garnerm91/J1850/ExampleGauge/readme.md

## BOM
- TXS0108 level shifter https://amzn.to/41ehUo2
- RP2040 https://amzn.to/454HPzP
- ST7789 1.69in display https://amzn.to/46y5laV
- J1850 VPW module https://www.ebay.com/usr/mattus.i8wvojtcv
## Example Gauge Drawing
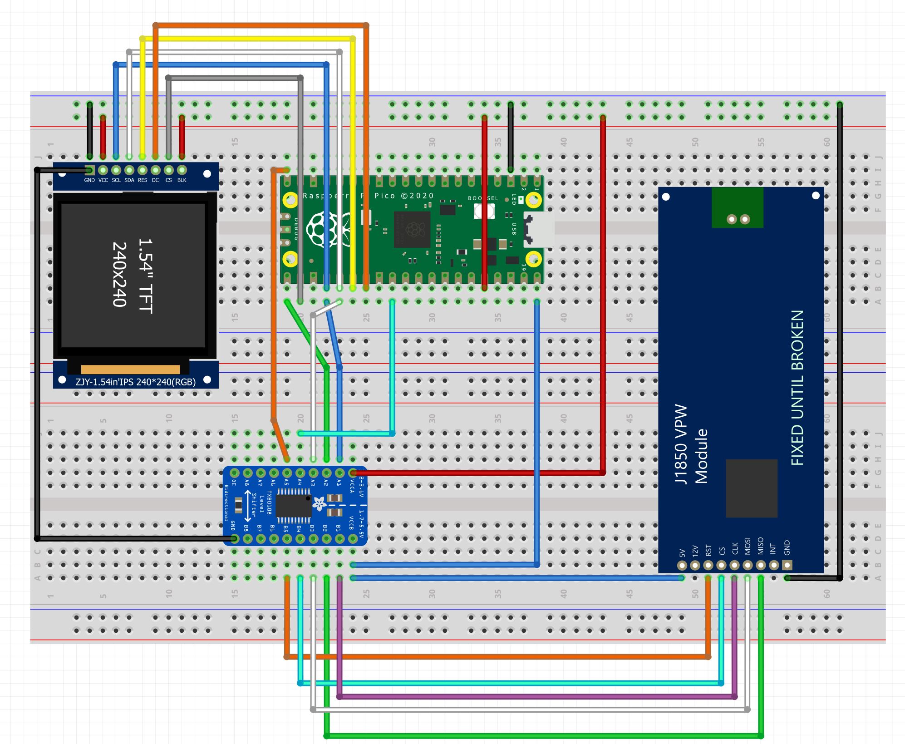
[picture p3: ExampleGauge/gauge.JPG]
PCB

* NOTE: I used a different screen in the drawing, but the one in the BOM is correct.
