garnerm91/J1850/xc68hc58_pro_fw/readme.txt

firmware to go with the xc68hc58 program
It is meant to be used on an Arduino ProMicro (Atmega32U4). The native USB has a more reliable serial for the Datalogging software that this project was meant for.
Tested on UNO as well and works but may have serial issues if pushed pass 115200 baud
