garnerm91/J1850/REVC/REVC SCH.pdf

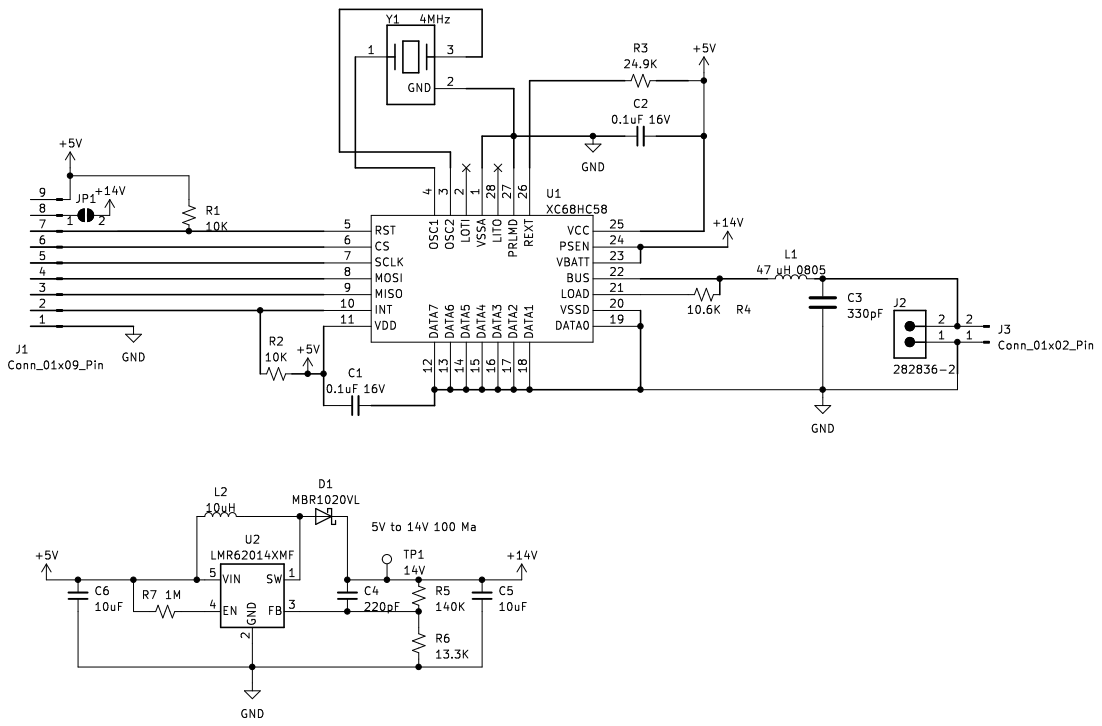
[picture p4: page 1]
