garnerm91/J1850/REV-B/PDF Sch.pdf

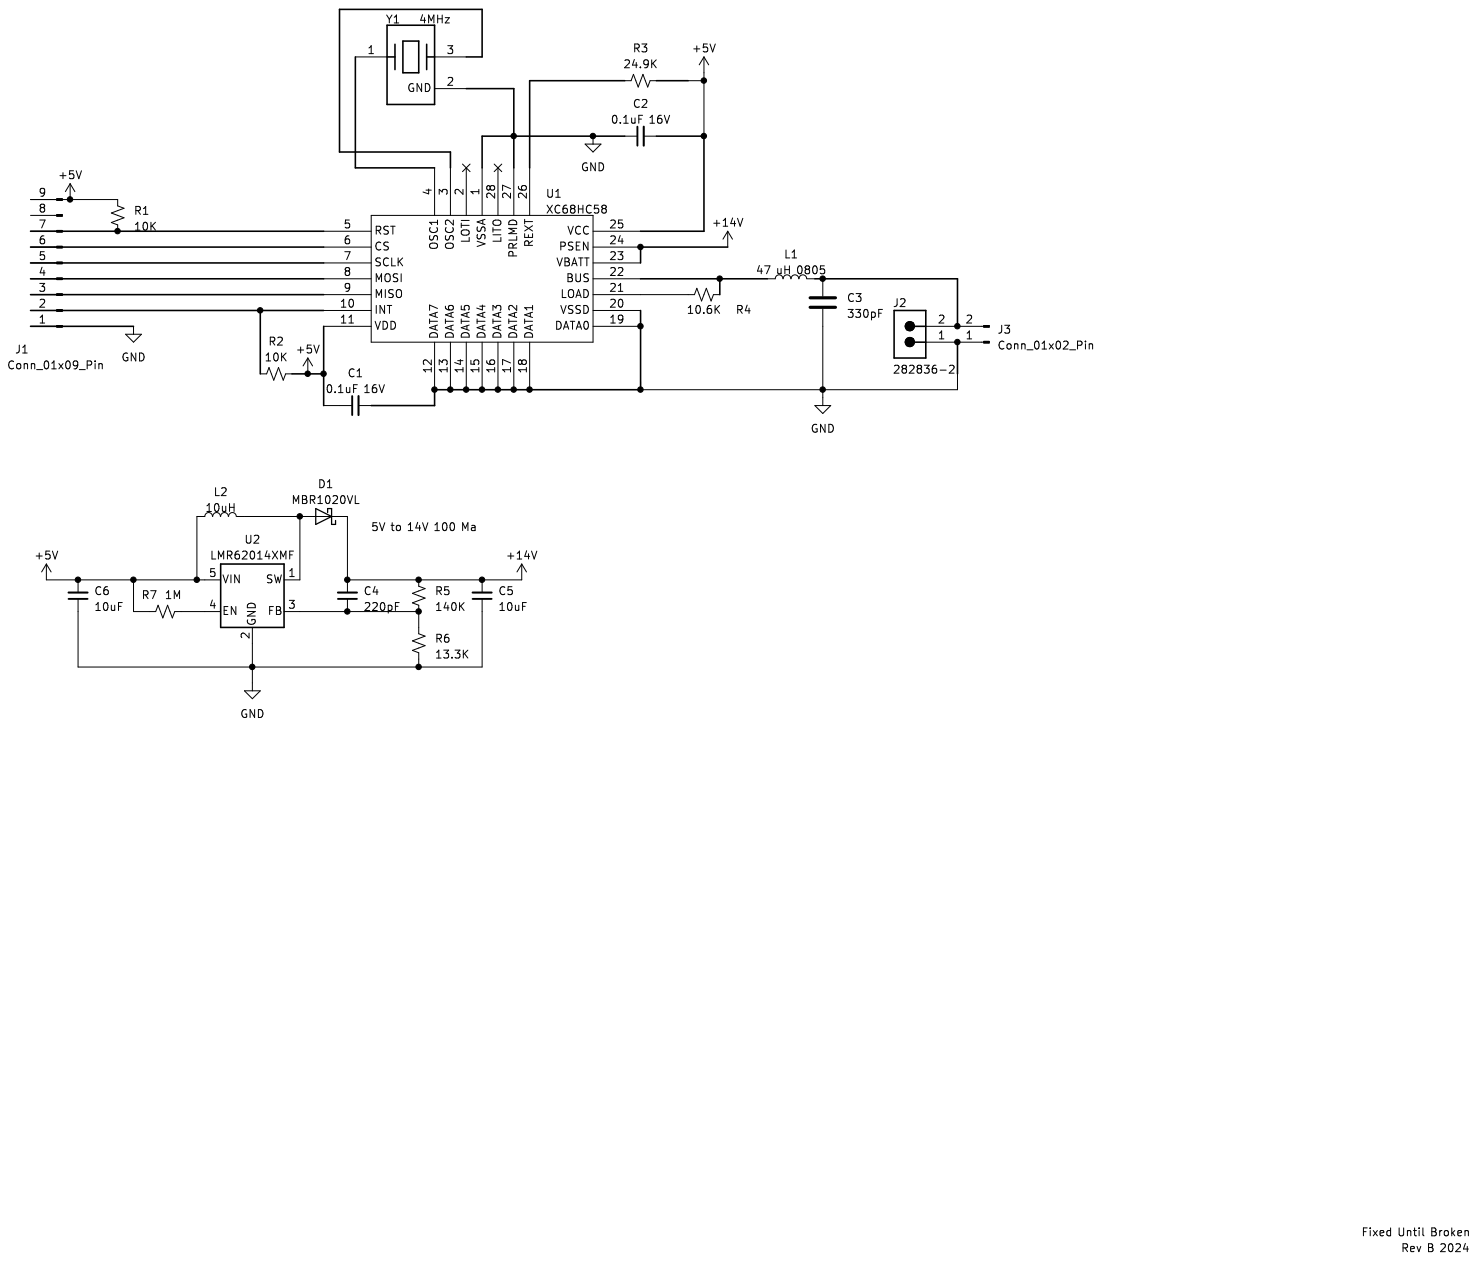
[picture p5: page 1]
