garnerm91/J1850/(commit log)

2024-06-16 Add files via upload
    Add Gerber and SCH
2024-07-06 ADD bom
    [J1850 REV C.csv]
2024-08-31 Update xc68hc58pro.ino
    fixed the order of spibegin/transact
    [xc68hc58pro.ino]
2024-12-14 Update xc68hc58pro.ino
    v0.3 push
    Bug fix in setup
    speed improvement to avoid RX buffer overrun
    [xc68hc58pro.ino]
2024-12-14 Update xc68hc58pro.ino
    updated to support arduino uno
2024-12-15 Update xc68hc58pro.ino
    V0.4 changes
    fixed leading digit on RX
    [xc68hc58pro.ino]
2026-09-23 Add notes for untested frames and frame format
2026-10-06 Add coolant temperature data format to known.txt
